wagiminator/ATtiny412-HamsterTracker/documentation/HamsterTracker_pic1.jpg

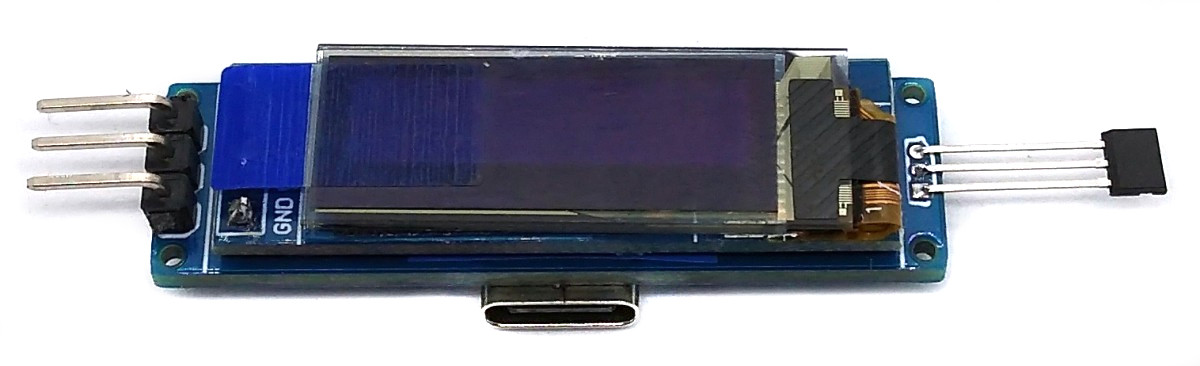
documentation/HamsterTracker_pic1.jpg
