wagiminator/ATtiny412-HamsterTracker/hardware/HamsterTracker_BOM.tsv

ID | Name | Designator | Footprint | Quantity | Manufacturer Part | Manufacturer | Supplier | Supplier Part | Price
1 | 4n7 | C1,C2 | C_0603_S | 2 | 0603B472K500NT | FH | LCSC | C53987 | 0.003
2 | 100n | C3 | C_0603_S | 1 | CC0603KRX7R9BB104 | YAGEO | LCSC | C14663 | 0.002
3 | UPDI | J1 | 210S-3X1/2.54 | 1 | Header2.54mm 1*3P | BOOMELE | LCSC | C49257 | 0.014
4 | SET | KEY1 | SW-SMD_TS24CA | 1 | TS24CA | SHOU HAN | LCSC | C393942 | 0.023
5 | OLED 0.91 | OLED1 | I2C OLED 0.91 | 1 | SSD1306 I2C OLED
6 | 1k2 | R1 | R_0603_S | 1 | 0603WAF1201T5E | UniOhm | LCSC | C22765 | 0.001
7 | 5k1 | R2,R3 | R_0603_S | 2 | 0603WAF5101T5E | UniOhm | LCSC | C23186 | 0.001
8 | TLE4935L | U1 | PG-SSO-3-2_L4.2-W1.5-P1.27-L | 1 | TLE4935L | Infineon Technologies | LCSC | C539801 | 1.715
9 | ATTINY412-SSN | U2 | SOP-8_150MIL | 1 | ATTINY412-SSN | MICROCHIP(美国微芯) | LCSC | C1338223 | 0.577
10 | USB-TYPE-C-6PIN | USB1 | USB-C-SMD-6P | 1 | TYPE-C-31-M-17 | Korean Hroparts Elec | LCSC | C283540 | 0.204
