wagiminator/ATtiny412-HamsterTracker/hardware/HamsterTracker_schematic.pdf

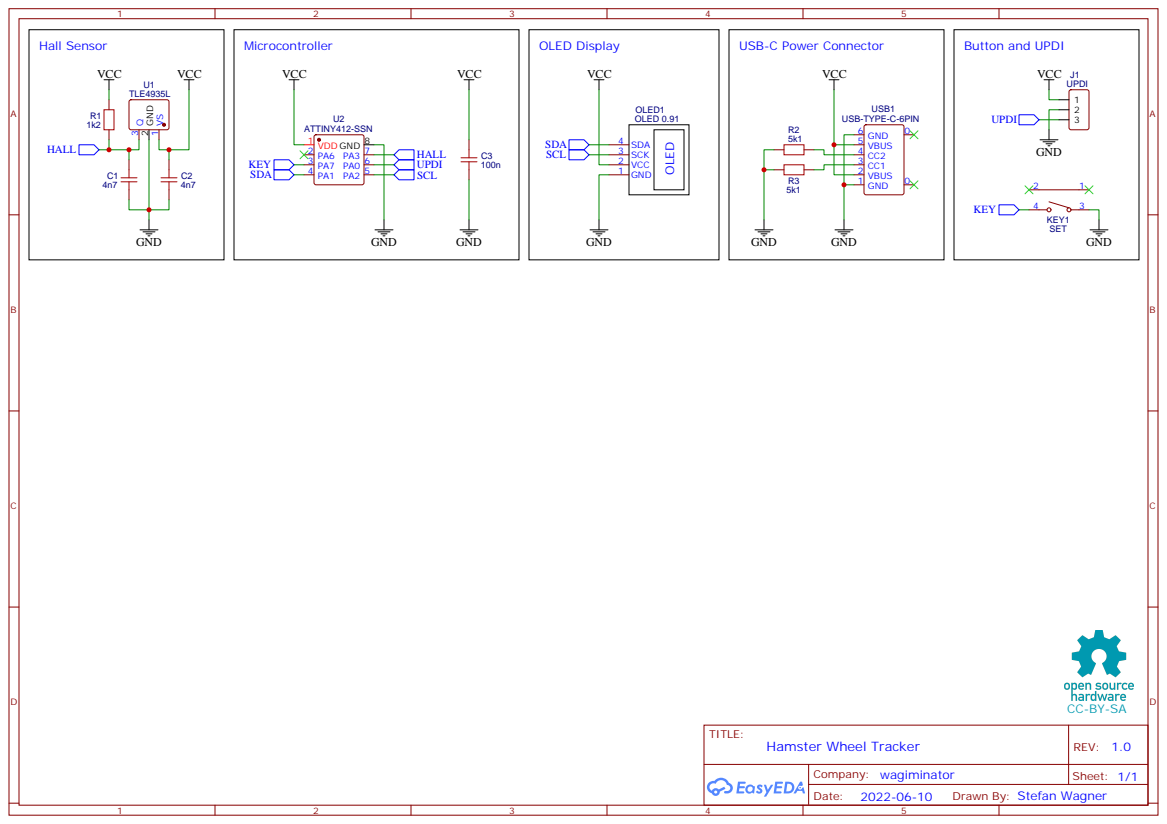
[picture p7: page 1]

Drawn By: Stefan Wagner
